Steven0811/moonwalk/cad/out/model_report.md

# Phase 2 — Model report

Generated by `cad/build.py` on 2026-10-03 21:30. Do not edit by hand.

Default foot variant (robot.yaml `foot_variant`): **wheel**. Hip roll: **off**.

## Check results (`cad/checks.py`)

**wheel foot**

| Check | Result | Details |
|---|---|---|
| Servo STEP: validation, measured dims = robot.yaml, simplified vs STEP bbox | PASS | case (20.0, 34.0, 22.97) mm (spec 34x20x23 ±0.3 on the case body; full model incl. horns+screws (20.0, 34.0, 30.2)); max |measured − robot.yaml| = 0.030 mm; holes match: True; cable exits match: True; simplified-vs-STEP bbox Δ = (0.0, 0.0, 0.0) mm |
| Joint positive directions (root CLAUDE.md conventions) | PASS | L: hip+ forward True, knee+ heel back True, ankle− toe down True; R: hip+ forward True, knee+ heel back True, ankle− toe down True |
| Zero pose: soles parallel, both at z = 0 (±0.5 mm) | PASS | L: sole parallel to ground True, lowest point z = +0.000 mm; R: sole parallel to ground True, lowest point z = +0.000 mm |
| Foot switch-over angle (wheel) | PASS | flat: support lowest +0.00 mm, pad 7.84 mm above it, foot body 1.50 mm above it; pad touches at 10.00° plantarflexion (design 10.0°, criterion 8–12°); foot body clearance at that angle 0.44 mm |
| Left/right symmetry (mass, CoM, joint origins mirrored) | PASS | thigh: Δm 0.000 g, Δcom(mirrored) 0.000 mm; shank: Δm 0.000 g, Δcom(mirrored) 0.000 mm; foot: Δm 0.000 g, Δcom(mirrored) 0.000 mm; wheel: Δm 0.000 g, Δcom(mirrored) 0.000 mm; base_link com x -0.75 mm (electronics placement, not mirrored) |
| Every printed part fits the build volume | PASS | bed 220×220×250 mm; all fit |
| Electronics placeholders in the tray, no mutual interference, battery inside the phase-1 region | PASS | battery over rail travel [-15, +15] mm: max overlap 0.00 mm³; phase-1 allowed battery Δy ∈ [-35, +35] mm → rail inside: True |
| Mass budget and CoM height vs phase 1 | PASS | total 382.3 g (limit 700 g); phase 1: 376.3 g → Δ +1.6 %; CoM height at the standing pose 118.8 mm vs phase 1 119.4 mm → Δ -0.5 % (criterion ±10 %) |
| Hard stops engage at the robot.yaml limits (±1°) | PASS | L_hip_pitch -30°: engages at -30.00° ✔; L_hip_pitch +90°: engages at +90.00° ✔; L_knee_pitch +0°: engages at -0.00° ✔; L_knee_pitch +120°: engages at +120.00° ✔; L_ankle_pitch -35°: engages at -35.00° ✔; L_ankle_pitch +30°: engages at +30.00° ✔ |
| Interference sweep | PASS | 107 poses (every joint over its full range at ≤ 5° steps, all 27 limit combinations per leg, both legs at limits), 41 s; no intersection > 0.05 mm³ between any two links or inside a link; 14 designed press fits (bearings/clutch in their seats, each ≤ 1.25 x its designed volume, largest 3.05 mm³) |
| Hip-roll variant (switch on) builds and passes | PENDING | NOT BUILT YET: hip_roll.enabled is false (default). The L_hip module is not modelled in this iteration; the pelvis plate keeps |x| 16–40 mm free and the hip modules are separate parts so it can be added later. |

**ptfe foot**

| Check | Result | Details |
|---|---|---|
| Servo STEP: validation, measured dims = robot.yaml, simplified vs STEP bbox | PASS | case (20.0, 34.0, 22.97) mm (spec 34x20x23 ±0.3 on the case body; full model incl. horns+screws (20.0, 34.0, 30.2)); max |measured − robot.yaml| = 0.030 mm; holes match: True; cable exits match: True; simplified-vs-STEP bbox Δ = (0.0, 0.0, 0.0) mm |
| Joint positive directions (root CLAUDE.md conventions) | PASS | L: hip+ forward True, knee+ heel back True, ankle− toe down True; R: hip+ forward True, knee+ heel back True, ankle− toe down True |
| Zero pose: soles parallel, both at z = 0 (±0.5 mm) | PASS | L: sole parallel to ground True, lowest point z = -0.500 mm; R: sole parallel to ground True, lowest point z = -0.500 mm |
| Foot switch-over angle (ptfe) | PASS | flat: sole lowest; pad 1.06 mm above; pad touches at 9.99° (criterion 8–12°) |
| Left/right symmetry (mass, CoM, joint origins mirrored) | PASS | thigh: Δm 0.000 g, Δcom(mirrored) 0.000 mm; shank: Δm 0.000 g, Δcom(mirrored) 0.000 mm; foot: Δm 0.000 g, Δcom(mirrored) 0.000 mm; base_link com x -0.75 mm (electronics placement, not mirrored) |
| Every printed part fits the build volume | PASS | bed 220×220×250 mm; all fit |
| Electronics placeholders in the tray, no mutual interference, battery inside the phase-1 region | PASS | battery over rail travel [-15, +15] mm: max overlap 0.00 mm³; phase-1 allowed battery Δy ∈ [-85, +90] mm → rail inside: True |
| Mass budget and CoM height vs phase 1 | PASS | total 374.4 g (limit 700 g); phase 1: 368.3 g → Δ +1.7 %; CoM height at the standing pose 124.2 mm vs phase 1 124.9 mm → Δ -0.6 % (criterion ±10 %) |
| Hard stops engage at the robot.yaml limits (±1°) | PASS | L_hip_pitch -30°: engages at -30.00° ✔; L_hip_pitch +90°: engages at +90.00° ✔; L_knee_pitch +0°: engages at -0.00° ✔; L_knee_pitch +120°: engages at +120.00° ✔; L_ankle_pitch -35°: engages at -35.00° ✔; L_ankle_pitch +30°: engages at +30.00° ✔ |
| Interference sweep | PASS | 107 poses (every joint over its full range at ≤ 5° steps, all 27 limit combinations per leg, both legs at limits), 33 s; no intersection > 0.05 mm³ between any two links or inside a link; 8 designed press fits (bearings/clutch in their seats, each ≤ 1.25 x its designed volume, largest 1.17 mm³) |
| Hip-roll variant (switch on) builds and passes | PENDING | NOT BUILT YET: hip_roll.enabled is false (default). The L_hip module is not modelled in this iteration; the pelvis plate keeps |x| 16–40 mm free and the hip modules are separate parts so it can be added later. |

## Mass, centre of mass, inertia per link

Link frame = origin on the joint axis to the parent, zero-pose orientation (Z up, +Y forward). Inertia about the CoM. The box check compares the trace of the inertia with that of a solid box of the link's bounding-box size and the same mass (an order-of-magnitude difference would mean a unit error).

### wheel foot — total **382.3 g**

| Link | Mass [g] | CoM [mm] | Ixx, Iyy, Izz [g·mm²] | Ixy, Ixz, Iyz | trace / box trace |
|---|---|---|---|---|---|
| base_link | 148.87 | -0.8, -0.2, +27.7 | 68530, 123950, 94993 | 21, 1044, 138 | 0.67 |
| L_thigh | 44.11 | -0.0, +0.4, -57.3 | 28050, 30133, 5688 | -1, -21, 377 | 0.63 |
| L_shank | 44.16 | -0.4, +0.5, -43.0 | 16910, 18627, 5030 | 372, -209, 180 | 0.48 |
| L_foot | 25.29 | -1.1, +2.0, -14.6 | 9517, 4750, 11230 | -0, 252, -559 | 0.79 |
| L_wheel | 3.16 | -0.0, +0.0, -0.0 | 17, 702, 702 | 0, -0, -0 | 1.21 |
| R_thigh | 44.11 | +0.0, +0.4, -57.3 | 28050, 30133, 5688 | 1, 21, 377 | 0.63 |
| R_shank | 44.16 | +0.4, +0.5, -43.0 | 16910, 18627, 5030 | -372, 209, 180 | 0.48 |
| R_foot | 25.29 | +1.1, +2.0, -14.6 | 9517, 4750, 11230 | 0, -252, -559 | 0.79 |
| R_wheel | 3.16 | -0.0, +0.0, +0.0 | 17, 702, 702 | -0, 0, -0 | 1.21 |

Whole-robot CoM at the zero pose: (-0.3, +0.1, 124.2) mm.

### ptfe foot — total **374.4 g**

| Link | Mass [g] | CoM [mm] | Ixx, Iyy, Izz [g·mm²] | Ixy, Ixz, Iyz | trace / box trace |
|---|---|---|---|---|---|
| base_link | 148.87 | -0.8, -0.2, +27.7 | 68530, 123950, 94993 | 21, 1044, 138 | 0.67 |
| L_thigh | 44.11 | -0.0, +0.4, -57.3 | 28050, 30133, 5688 | -1, -21, 377 | 0.63 |
| L_shank | 44.16 | -0.4, +0.5, -43.0 | 16910, 18627, 5030 | 372, -209, 180 | 0.48 |
| L_foot | 24.50 | -1.3, +5.4, -17.6 | 8339, 5152, 8992 | -114, 323, 410 | 0.71 |
| R_thigh | 44.11 | +0.0, +0.4, -57.3 | 28050, 30133, 5688 | 1, 21, 377 | 0.63 |
| R_shank | 44.16 | +0.4, +0.5, -43.0 | 16910, 18627, 5030 | -372, 209, 180 | 0.48 |
| R_foot | 24.50 | +1.3, +5.4, -17.6 | 8339, 5152, 8992 | 114, -323, 410 | 0.71 |

Whole-robot CoM at the zero pose: (-0.3, +0.8, 126.3) mm.

### Bodies per link (left leg; the right is the mirror image)

| Link | Body | Material | Mass [g] | Note |
|---|---|---|---|---|
| base_link | hip_module_L | petg_structural | 8.00 | print on its side (X vertical): sagittal loads stay in-layer |
| base_link | hip_module_R | petg_structural | 8.00 | print on its side (X vertical): sagittal loads stay in-layer |
| base_link | hip_servo_L | purchased | 21.00 |  |
| base_link | hip_servo_R | purchased | 21.00 |  |
| base_link | pelvis_plate | petg_structural | 8.46 | print flat (Z up): the hip loads bend it about Y, stresses along X stay in-layer |
| base_link | tray | petg_light | 7.81 |  |
| base_link | elec_battery | purchased | 30.00 | placeholder |
| base_link | elec_controller | purchased | 12.00 | placeholder |
| base_link | elec_bus_adapter | purchased | 6.00 | placeholder |
| base_link | elec_imu | purchased | 2.00 | placeholder |
| base_link | elec_power_switch | purchased | 1.00 | placeholder |
| base_link | screws_hip_module_L | purchased | 3.00 |  |
| base_link | screws_hip_module_R | purchased | 3.00 |  |
| base_link | screws_tray | purchased | 2.60 |  |
| base_link | wiring_base | purchased | 15.00 | bus wiring, battery leads, switch leads |
| L_thigh | thigh | petg_structural | 17.11 | print on its side (X vertical) |
| L_thigh | knee_servo | purchased | 21.00 |  |
| L_thigh | screws_hip_horns | purchased | 2.00 |  |
| L_thigh | screws_knee_servo_case | purchased | 1.00 |  |
| L_thigh | wiring_thigh | purchased | 3.00 |  |
| L_shank | shank | petg_structural | 12.30 | print on its side (X vertical) |
| L_shank | ankle_cover | petg_structural | 0.95 | inner side wall of the ankle-servo pocket; 4 x M2 + 2 case screws |
| L_shank | ankle_servo | purchased | 21.00 |  |
| L_shank | ankle_bearing_out | purchased | 0.30 | MR63ZZ |
| L_shank | ankle_bearing_in | purchased | 0.30 | MR63ZZ |
| L_shank | screws_knee_horns | purchased | 2.00 |  |
| L_shank | screws_ankle_servo_case | purchased | 1.50 |  |
| L_shank | crank_insert | purchased | 0.15 |  |
| L_shank | ankle_cover_screws_inserts | purchased | 1.60 |  |
| L_shank | wiring_shank | purchased | 2.00 |  |
| L_shank | crank | petg_structural | 0.61 |  |
| L_shank | rod | petg_structural | 0.46 |  |
| L_shank | rod_bearing_crank | purchased | 0.20 | MR52ZZ |
| L_shank | pin_crank | purchased | 0.30 | M2x8 shoulder screw |
| L_shank | rod_bearing_lever | purchased | 0.20 | MR52ZZ |
| L_shank | pin_lever | purchased | 0.30 | M2x8 shoulder screw |
| L_foot | foot | petg_structural | 19.75 | wheel variant; print on its side (X vertical) |
| L_foot | toe_pad | tpu_85a | 1.89 | print face down |
| L_foot | ankle_pin | purchased | 2.30 | M3x30 screw + M3 nylock nut |
| L_foot | lever_insert | purchased | 0.15 |  |
| L_foot | wheel_clutch | purchased | 0.60 | HF0306 one-way needle clutch |
| L_foot | wheel_bearing_out | purchased | 0.30 | MR63ZZ |
| L_foot | wheel_bearing_in | purchased | 0.30 | MR63ZZ |
| L_wheel | wheel_out | tpu_85a | 0.38 |  |
| L_wheel | wheel_in | tpu_85a | 0.38 |  |
| L_wheel | axle | purchased | 2.40 | 3 mm hardened steel pin |
| L_foot (ptfe) | foot | petg_structural | 19.16 | ptfe variant; print on its side (X vertical) |
| L_foot (ptfe) | toe_pad | tpu_85a | 1.89 | print face down |
| L_foot (ptfe) | ankle_pin | purchased | 2.30 | M3x30 screw + M3 nylock nut |
| L_foot (ptfe) | lever_insert | purchased | 0.15 |  |
| L_foot (ptfe) | ptfe_tape | purchased | 1.00 | PTFE tape on the sole |

### Mass budget (cad/CLAUDE.md) vs model

| Item | Budget | Model |
|---|---|---|
| servos | 126 g | 126.0 g |
| electronics | ~55 g (battery 30 + boards 25) | 51.0 g |
| printed | ~300 g | 138.4 g |
| hardware/wiring | ~80 g | 60.6 g |
| wheel set | 6–12 g | 6.3 g |
| **total** | ~570 g, limit 700 g | **382.3 g** |

Printed masses use the effective densities in robot.yaml (estimates until the slicer / scale gives real numbers). The printed structure is far lighter than the 300 g budget line: the parts are thin (2–3.5 mm walls) and the effective density assumes 4 walls + 30 % gyroid.

## Servo model (vendor STEP)

Source `cad/vendor/feetech_hd1910/HD-1910-C001.stp` (see SOURCE.md). Servo frame S: origin on the output-shaft axis at the output-horn face, +Z out of the output horn, +Y toward the case's long end. Measured in code:

| Quantity (S frame, mm) | Measured |
|---|---|
| case | [20.0, 34.0, 22.97] |
| case_center | [0.0, 7.5, -14.49] |
| horn_diameter | 15.99 |
| horn_thickness | 4.0 |
| horn_face_to_case | 3.0 |
| idle_horn_face_z | -29.0 |
| horn_hole_pcd | 12.0 |
| mount_hole_depth | 3.5 |
| horn_hole_count | 8 |
| mount_holes | [[-8.0, -7.5], [-8.0, 22.5], [8.0, -7.5], [8.0, 22.5]] |
| cable_exit | [[-10.000000000000114, 8.75, -18.45], [10.000000000000114, 8.75, -18.45]] |

Simplified shape (case box + horn discs + horn-screw heads) vs full STEP bounding box: Δ = (0.0, 0.0, 0.0) mm (criterion < 0.5 mm). Validation note: the spec's 34 × 20 × 23 mm bounding-box check applies to the case body (measured 34.00 × 20.00 × 22.97 mm). The full STEP also contains both horns and their screws, 20 × 34 × 30.2 mm; horn face to horn face is 29.0 mm, as on the datasheet. Units are mm.

## Joints (URDF)

| Joint | Parent → child | Origin [mm] | Axis | Range [°] | Effort / velocity |
|---|---|---|---|---|---|
| L_hip_pitch | base_link → L_thigh | -28.0, +0.0, +0.0 | (1, 0, 0) | -30 … +90 | 0.88 N·m / 7.64 rad/s |
| L_knee_pitch | L_thigh → L_shank | +0.0, +0.0, -80.0 | (-1, 0, 0) | +0 … +120 | 0.88 N·m / 7.64 rad/s |
| L_ankle_pitch | L_shank → L_foot | +0.0, +0.0, -72.0 | (1, 0, 0) | -35 … +30 | 0.88 N·m / 7.64 rad/s |
| L_wheel_axle | L_foot → L_wheel | +0.0, -18.0, -22.0 | (1, 0, 0) | continuous (passive) | — |
| R_hip_pitch | base_link → R_thigh | +28.0, +0.0, +0.0 | (1, 0, 0) | -30 … +90 | 0.88 N·m / 7.64 rad/s |
| R_knee_pitch | R_thigh → R_shank | +0.0, +0.0, -80.0 | (-1, 0, 0) | +0 … +120 | 0.88 N·m / 7.64 rad/s |
| R_ankle_pitch | R_shank → R_foot | +0.0, +0.0, -72.0 | (1, 0, 0) | -35 … +30 | 0.88 N·m / 7.64 rad/s |
| R_wheel_axle | R_foot → R_wheel | +0.0, -18.0, -22.0 | (1, 0, 0) | continuous (passive) | — |

Servo rotation sense (for firmware): every servo's output horn faces outward. For the left leg the servo +Z_S is −X, so a positive servo rotation (CCW seen from the horn) is a rotation about −X: hip and ankle angles = −servo angle, knee angle = +servo angle. For the right leg (+Z_S = +X) the signs flip. Measure this on the bench before trusting it.

Ankle drive: parallelogram linkage (crank 12 mm on the ankle servo, rod, equal lever on the foot), so ankle angle = servo angle. The URDF models the ankle as a direct revolute joint; crank and rod mass is lumped into the shank. **Estimated linkage backlash 0.2° (two MR52ZZ pin joints) on top of the servo's 0.5° → train/ servo model: ankle backlash ≈ 0.7°.**

## Collision primitives (names for train/ physics-material binding)

| Link | Name | Type | Zone | Centre [mm] | Size [mm] | rpy [°] |
|---|---|---|---|---|---|---|
| base_link (wheel) | `base_link_body` | box | body | +0.0, +0.0, +11.4 | 88.0, 20.0, 30.9 | 0, 0, 0 |
| base_link (wheel) | `base_link_tray` | box | body | +0.0, +0.0, +36.0 | 86.0, 42.0, 18.1 | 0, 0, 0 |
| base_link (wheel) | `base_link_battery` | box | body | +0.0, +0.0, +53.0 | 32.0, 58.0, 16.0 | 0, 0, 0 |
| L_thigh (wheel) | `L_thigh_body` | box | body | +0.0, +0.0, -52.5 | 32.0, 22.8, 72.0 | 0, 0, 0 |
| L_shank (wheel) | `L_shank_body` | box | body | +0.0, +0.0, -43.6 | 24.6, 22.0, 37.3 | 0, 0, 0 |
| L_foot (wheel) | `L_foot_toe_pad` | box | toe_pad | +0.0, +34.0, -16.3 | 44.0, 15.8, 3.0 | 18, 0, 0 |
| L_foot (wheel) | `L_foot_heel` | box | heel | +0.0, -18.0, -25.0 | 35.2, 16.0, 3.0 | 0, 0, 0 |
| L_foot (wheel) | `L_foot_body` | box | body | +0.0, +1.0, -8.5 | 42.0, 50.0, 9.0 | 0, 0, 0 |
| L_wheel (wheel) | `L_wheel_out` | sphere | wheel | -20.0, +0.0, +0.0 | 6.0 | 0, 0, 0 |
| L_wheel (wheel) | `L_wheel_in` | sphere | wheel | +20.0, +0.0, +0.0 | 6.0 | 0, 0, 0 |
| L_foot (ptfe) | `L_foot_toe_pad` | box | toe_pad | +0.0, +34.0, -23.1 | 44.0, 15.8, 3.0 | 18, 0, 0 |
| L_foot (ptfe) | `L_foot_heel` | box | heel | +0.0, -20.0, -26.5 | 44.0, 12.0, 3.0 | 0, 0, 0 |
| L_foot (ptfe) | `L_foot_sole` | box | sole | +0.0, +3.5, -26.5 | 44.0, 35.0, 3.0 | 0, 0, 0 |
| L_foot (ptfe) | `L_foot_body` | box | body | +0.0, +1.0, -8.5 | 42.0, 50.0, 9.0 | 0, 0, 0 |

Naming scheme (robot.yaml `collision.names`): `{side}_foot_toe_pad`, `{side}_foot_sole`, `{side}_foot_heel`, `{side}_wheel_in` / `_out` (spheres), `{side}_{link}_body`, `base_link_*`.

## Printed parts (`cad/out/stl/`, already in print orientation)

| File | Material | Mass est. [g] | Size in print orientation [mm] | Note |
|---|---|---|---|---|
| ankle_cover_L.stl | petg_structural | 0.9 | 38 × 32 × 2 | inner side wall of the ankle-servo pocket; 4 x M2 + 2 case screws |
| ankle_cover_R.stl | petg_structural | 0.9 | 38 × 32 × 2 | inner side wall of the ankle-servo pocket; 4 x M2 + 2 case screws |
| crank_L.stl | petg_structural | 0.6 | 18 × 26 × 4 |  |
| crank_R.stl | petg_structural | 0.6 | 18 × 26 × 4 |  |
| foot_ptfe_L.stl | petg_structural | 19.2 | 35 × 67 × 44 | ptfe variant; print on its side (X vertical) |
| foot_ptfe_R.stl | petg_structural | 19.2 | 35 × 67 × 44 | ptfe variant; print on its side (X vertical) |
| foot_wheel_L.stl | petg_structural | 19.7 | 34 × 67 × 44 | wheel variant; print on its side (X vertical) |
| foot_wheel_R.stl | petg_structural | 19.7 | 34 × 67 × 44 | wheel variant; print on its side (X vertical) |
| hip_module_L.stl | petg_structural | 8.0 | 32 × 34 × 34 | print on its side (X vertical): sagittal loads stay in-layer |
| hip_module_R.stl | petg_structural | 8.0 | 32 × 34 × 34 | print on its side (X vertical): sagittal loads stay in-layer |
| pelvis_plate.stl | petg_structural | 8.5 | 90 × 44 × 3 | print flat (Z up): the hip loads bend it about Y, stresses along X stay in-layer |
| rod_L.stl | petg_structural | 0.5 | 43 × 8 × 3 |  |
| rod_R.stl | petg_structural | 0.5 | 43 × 8 × 3 |  |
| shank_L.stl | petg_structural | 12.3 | 95 × 32 × 34 | print on its side (X vertical) |
| shank_R.stl | petg_structural | 12.3 | 95 × 32 × 34 | print on its side (X vertical) |
| thigh_L.stl | petg_structural | 17.1 | 109 × 27 × 34 | print on its side (X vertical) |
| thigh_R.stl | petg_structural | 17.1 | 109 × 27 × 34 | print on its side (X vertical) |
| toe_pad_L.stl | tpu_85a | 1.9 | 44 × 16 × 5 | print face down |
| toe_pad_R.stl | tpu_85a | 1.9 | 44 × 16 × 5 | print face down |
| tolerance_holes.stl | petg_structural | 19.9 | 50 × 90 × 6 |  |
| tolerance_horn.stl | petg_structural | 4.7 | 70 × 24 × 4 |  |
| tolerance_servo_collars.stl | petg_structural | 2.8 | 79 × 39 × 5 |  |
| tray.stl | petg_light | 7.8 | 88 × 60 × 15 |  |
| wheel.stl | tpu_85a | 0.4 | 12 × 12 × 4 |  |

First print **tolerance_holes / tolerance_horn / tolerance_servo_collars** and report which sizes fit; the values go to robot.yaml `print:`.

## Views

iso wheel
iso_back wheel
front wheel
side wheel
top wheel

gait wheel

iso ptfe
iso_back ptfe
front ptfe
side ptfe
top ptfe

gait ptfe

Build time 280 s.
