Steven0811/moonwalk/cad/out/sizing_report.md

# Phase 1 — Sizing feasibility report

Generated by `cad/analysis/sizing_report.py` on 2026-10-01 22:41. Do not edit by hand.

Method: quasi-static analysis of the 4-s slow gait in `config/gait.yaml` (both halves, 60 samples per half). Each sample is an equilibrium pose: feet roll without slipping between the flat / switch / toe states, the pelvis height is constant, the pelvis fore-aft keyframes are optimised to maximise the worst static margin. Margins are measured along the Y line (fore-aft) and X line (lateral) through the CoM projection, as the spec states; the Euclidean distance to the nearest polygon edge is listed for information. Torques: static gravity + ground reaction, with the sliding foot carrying a forward friction force μ = 0.15 (worst case of the 0.05–0.15 target) reacted by the support foot. Because two feet on the ground make the load split statically indeterminate, two numbers are given: **best** = the split minimising the largest torque ratio (what a good controller can reach), **worst** = the largest |τ| over every admissible split (an upper bound, independent of the controller). The pass criterion uses the worst case.

## 1. Selected design (values now in config/)

| Parameter | Value |
|---|---|
| Leg length (hip axis → sole) | 180 mm |
| Thigh / shank | 80 / 72 mm |
| Ankle height | 28 mm |
| Stance width (hip spacing) | 56 mm |
| Foot toe / heel length, width | 42 / 26 mm, 44 mm |
| Toe pad length, wedge face angle | 15 mm, 18° |
| Switch-over angle (design) | 10° |
| Wheel Ø, axle y, track | 12 mm, -18 mm, 40 mm |
| PTFE sole front edge → pad gap | 6 mm |
| Step length (per cycle) | 40 mm |
| Cycle time | 4.0 s |

| Metric (both halves of the cycle) | wheel | ptfe | Criterion |
|---|---|---|---|
| Hip height H (derived: back-of-slide knee = 27°) | 174.3 mm (96.8 % of leg) | 175.3 mm (97.4 % of leg) | 90–95 % suggested |
| Knee of sliding leg at back of slide | 27.0° | 27.0° | 15–30° |
| Reachable, all joints in range, knee ≥ 5° throughout | yes | yes | yes |
| Min fore-aft margin | 14.1 mm | 20.4 mm | ≥ 10 mm |
| Min lateral margin | 14.1 mm | 27.9 mm | ≥ 10 mm |
| Min Euclidean margin (info) | 10.8 mm | 17.5 mm | — |
| Static τ p99 hip: worst / best | 0.064 / 0.050 N·m (30 %) | 0.098 / 0.027 N·m (45 %) | worst ≤ 0.216 |
| Static τ p99 knee: worst / best | 0.057 / 0.052 N·m (26 %) | 0.060 / 0.039 N·m (28 %) | worst ≤ 0.216 |
| Static τ p99 ankle: worst / best | 0.071 / 0.064 N·m (33 %) | 0.064 / 0.039 N·m (29 %) | worst ≤ 0.216 |
| Joint angle range used: hip | 2.0 … 16.4° | 7.7 … 26.4° | −30 … 90 |
| knee | 16.1 … 31.5° | 26.8 … 43.2° | 0 … 120 |
| ankle | -4.7 … 22.4° | -3.4 … 19.1° | −35 … 30 |
| Total mass (estimate) | 376 g | 368 g | ≤ 700 g |
| Mean CoM height | 120.8 mm | 125.1 mm | phase-2 check ±10 % |
| **Pass** | **yes** | **yes** |  |

Pelvis keyframes (wheel), y relative to the support foot's flat position: slide_start +22.6, slide_mid +19.4, slide_end +1.1, transfer -1.6, raise +3.3 mm.

Pelvis keyframes (ptfe), y relative to the support foot's flat position: slide_start +10.1, slide_mid +3.2, slide_end -7.7, both_flat -7.1 mm.

cycle wheel
cycle ptfe

keyframes wheel
polygons wheel

keyframes ptfe
polygons ptfe

## 2. Foot geometry and switch-over angle

The toe pad is a TPU **wedge**: its face rises toward the toe at the face angle, so in the toe-raised support state the whole pad face is flat on the ground (a patch, not a line). Its rear edge is recessed above the ground so that, as the foot plantarflexes about its first pivot (wheel axle, or PTFE sole front edge), the rear edge touches exactly at the switch-over angle. Recess = f(pivot, switch angle); it is derived, not typed.

| | wheel | ptfe |
|---|---|---|
| First pivot (y, z) in foot frame | (-18.0, -22.0) | (21.0, -28.0) |
| Pad rear-edge recess above ground (flat) | 7.84 mm | 1.06 mm |
| Pad tip height above ground (flat) | 12.72 mm | 5.93 mm |
| θ = 0° plantarflexion: touching | wheel, wheel bottom 0.0 mm | sole |
| θ = 5° plantarflexion: touching | wheel, wheel bottom 0.0 mm | sole |
| θ = 8° plantarflexion: touching | wheel, wheel bottom 0.0 mm | sole |
| θ = 10° plantarflexion: touching | pad+wheel, wheel bottom 0.0 mm | pad+sole |
| θ = 12° plantarflexion: touching | pad, wheel bottom 1.6 mm | pad |
| θ = 15° plantarflexion: touching | pad, wheel bottom 3.9 mm | pad |
| θ = 18° plantarflexion: touching | pad, wheel bottom 6.2 mm | pad |
| θ = 22° plantarflexion: touching | pad, wheel bottom 10.2 mm | pad |

Switch-over at 10° (criterion 8–12°): flat → only wheels / sole touch; at 10° the pad rear edge joins; past it the wheels lift; at 18° the whole pad face is down.

Wheel parts (starting choice, fits the 10 mm wheel): 3 mm steel axle, one-way needle clutch HF0306 (3 × 6.5 × 6 mm) pressed into the foot body on the axle, MR63ZZ (3 × 6 × 2.5) on the other side; the two printed rims are fixed to the axle so both lock together. Estimated set mass ≈ 4 g per foot (< 6 g). Interference of the wheels with the ankle linkage is checked in phase 2 (`cad/checks.py`); in phase 1 the ankle lever (r = 12 mm about the ankle axis) sweeps z ≥ −7 mm in the foot frame, the wheel top is at z = -16 mm: clear by ≥ 9 mm.

## 3. Sweeps

Every row re-derives the hip height (knee 27° at the back of the slide unless the row varies it) and re-optimises the pelvis keyframes. `fa`/`lat` = minimum fore-aft / lateral margin [mm]; τ = worst-case static p99 [N·m] hip/knee/ankle. ✔ = all criteria met.

### Leg length (thigh, shank, ankle height scaled together) (wheel)

| scale (1.0 = 180 mm) | H [mm] | knee@back | fa | lat | τ hip / knee / ankle | feasible | ✔ |
|---|---|---|---|---|---|---|---|
| 0.85 | 147 | 28.5 | 14.9 | 14.9 | 0.063 / 0.060 / 0.067 | yes | ✔ |
| 0.9 | 157 | 27.3 | 14.7 | 14.7 | 0.064 / 0.062 / 0.073 | yes | ✔ |
| 1.0 | 174 | 27.0 | 14.1 | 14.1 | 0.064 / 0.057 / 0.071 | yes | ✔ |
| 1.1 | 192 | 26.9 | 14.0 | 14.0 | 0.064 / 0.064 / 0.069 | yes | ✔ |
| 1.2 | 210 | 27.1 | 14.0 | 14.0 | 0.064 / 0.060 / 0.068 | yes | ✔ |

### Thigh share of thigh + shank (wheel)

| thigh fraction | H [mm] | knee@back | fa | lat | τ hip / knee / ankle | feasible | ✔ |
|---|---|---|---|---|---|---|---|
| 0.48 | 174 | 27.0 | 14.0 | 14.0 | 0.064 / 0.060 / 0.071 | yes | ✔ |
| 0.5 | 174 | 26.8 | 14.0 | 14.0 | 0.064 / 0.064 / 0.071 | yes | ✔ |
| 0.526 | 174 | 27.0 | 14.1 | 14.1 | 0.064 / 0.057 / 0.076 | yes | ✔ |
| 0.55 | 174 | 27.4 | 14.5 | 14.5 | 0.064 / 0.063 / 0.075 | yes | ✔ |
| 0.58 | 174 | 26.9 | 14.3 | 14.3 | 0.063 / 0.057 / 0.075 | yes | ✔ |

### Ankle height (wheel)

| ankle height [mm] | H [mm] | knee@back | fa | lat | τ hip / knee / ankle | feasible | ✔ |
|---|---|---|---|---|---|---|---|
| 22.0 | 168 | 27.1 | 14.4 | 14.4 | 0.064 / 0.065 / 0.080 | yes | ✔ |
| 25.0 | 171 | 27.0 | 14.1 | 14.1 | 0.064 / 0.057 / 0.079 | yes | ✔ |
| 28.0 | 174 | 27.0 | 14.1 | 14.1 | 0.064 / 0.057 / 0.071 | yes | ✔ |
| 32.0 | 178 | 27.0 | 14.0 | 14.0 | 0.063 / 0.060 / 0.069 | yes | ✔ |
| 36.0 | 182 | 27.1 | 14.0 | 14.0 | 0.063 / 0.064 / 0.066 | yes | ✔ |

### Nominal hip height (via the back-of-slide knee angle) (wheel)

| knee@back target [°] | H [mm] | knee@back | fa | lat | τ hip / knee / ankle | feasible | ✔ |
|---|---|---|---|---|---|---|---|
| 15.0 | 177 | 14.8 | 14.0 | 14.3 | — | unreachable @ slide_end | ✘ |
| 20.0 | 176 | 19.9 | 12.9 | 14.2 | — | unreachable @ slide_end | ✘ |
| 27.0 | 174 | 27.0 | 14.1 | 14.1 | 0.064 / 0.057 / 0.071 | yes | ✔ |
| 30.0 | 173 | 31.0 | 15.3 | 15.3 | 0.064 / 0.063 / 0.070 | yes | ✘ |
| 40.0 | 170 | 40.1 | 15.4 | 15.4 | 0.064 / 0.067 / 0.067 | yes | ✘ |

### Step length (wheel)

| step [mm] | H [mm] | knee@back | fa | lat | τ hip / knee / ankle | feasible | ✔ |
|---|---|---|---|---|---|---|---|
| 20.0 | 175 | 26.6 | 15.5 | 15.5 | 0.058 / 0.058 / 0.076 | yes | ✔ |
| 30.0 | 175 | 27.4 | 15.5 | 15.5 | 0.061 / 0.065 / 0.073 | yes | ✔ |
| 40.0 | 174 | 27.0 | 14.1 | 14.1 | 0.064 / 0.057 / 0.071 | yes | ✔ |
| 50.0 | 174 | 27.9 | 14.2 | 14.9 | 0.066 / 0.061 / 0.074 | yes | ✔ |
| 60.0 | 173 | 27.7 | 12.3 | 13.3 | 0.069 / 0.061 / 0.078 | yes | ✔ |

### Foot width (wheel)

| width [mm] | H [mm] | knee@back | fa | lat | τ hip / knee / ankle | feasible | ✔ |
|---|---|---|---|---|---|---|---|
| 32.0 | 175 | 27.3 | 9.7 | 9.7 | 0.064 / 0.059 / 0.067 | yes | ✘ |
| 36.0 | 174 | 27.0 | 10.7 | 10.7 | 0.064 / 0.067 / 0.071 | yes | ✔ |
| 40.0 | 174 | 27.0 | 12.7 | 12.7 | 0.064 / 0.057 / 0.074 | yes | ✔ |
| 44.0 | 174 | 27.0 | 14.1 | 14.1 | 0.064 / 0.057 / 0.071 | yes | ✔ |
| 48.0 | 174 | 27.2 | 16.1 | 16.1 | 0.064 / 0.059 / 0.076 | yes | ✔ |

### Stance width (wheel)

| hip spacing [mm] | H [mm] | knee@back | fa | lat | τ hip / knee / ankle | feasible | ✔ |
|---|---|---|---|---|---|---|---|
| 48.0 | 174 | 27.0 | 15.5 | 15.5 | 0.064 / 0.054 / 0.075 | yes | ✔ |
| 52.0 | 174 | 27.0 | 15.1 | 15.0 | 0.064 / 0.056 / 0.075 | yes | ✔ |
| 56.0 | 174 | 27.0 | 14.1 | 14.1 | 0.064 / 0.057 / 0.071 | yes | ✔ |
| 62.0 | 174 | 27.5 | 14.1 | 14.1 | 0.064 / 0.061 / 0.074 | yes | ✔ |
| 68.0 | 174 | 27.0 | 13.0 | 13.3 | 0.064 / 0.061 / 0.066 | yes | ✔ |

### Toe length (wheel)

| toe [mm] | H [mm] | knee@back | fa | lat | τ hip / knee / ankle | feasible | ✔ |
|---|---|---|---|---|---|---|---|
| 36.0 | 175 | 29.0 | 13.8 | 14.0 | 0.057 / 0.057 / 0.061 | yes | ✔ |
| 39.0 | 175 | 26.9 | 13.7 | 13.7 | 0.061 / 0.062 / 0.064 | yes | ✔ |
| 42.0 | 174 | 27.0 | 14.1 | 14.1 | 0.064 / 0.057 / 0.071 | yes | ✔ |
| 46.0 | 174 | 27.5 | 15.4 | 15.4 | 0.067 / 0.065 / 0.081 | yes | ✔ |
| 50.0 | 174 | 22.8 | 14.8 | 14.8 | 0.070 / 0.063 / 0.094 | yes | ✔ |

### Step length (ptfe)

| step [mm] | H [mm] | knee@back | fa | lat | τ hip / knee / ankle | feasible | ✔ |
|---|---|---|---|---|---|---|---|
| 20.0 | 176 | 27.0 | 19.0 | 26.6 | 0.096 / 0.060 / 0.055 | yes | ✔ |
| 30.0 | 176 | 25.8 | 19.5 | 27.9 | 0.096 / 0.059 / 0.060 | yes | ✔ |
| 40.0 | 175 | 27.0 | 20.4 | 27.9 | 0.098 / 0.060 / 0.064 | yes | ✔ |
| 50.0 | 175 | 27.0 | 20.6 | 28.4 | 0.098 / 0.060 / 0.069 | yes | ✔ |
| 60.0 | 175 | 27.2 | 20.3 | 28.0 | 0.099 / 0.062 / 0.075 | yes | ✔ |

### Foot width (ptfe)

| width [mm] | H [mm] | knee@back | fa | lat | τ hip / knee / ankle | feasible | ✔ |
|---|---|---|---|---|---|---|---|
| 32.0 | 175 | 26.9 | 17.8 | 22.2 | 0.076 / 0.059 / 0.060 | yes | ✔ |
| 36.0 | 175 | 27.0 | 18.4 | 24.4 | 0.082 / 0.059 / 0.061 | yes | ✔ |
| 40.0 | 175 | 27.6 | 19.7 | 25.9 | 0.090 / 0.060 / 0.062 | yes | ✔ |
| 44.0 | 175 | 27.0 | 20.4 | 27.9 | 0.098 / 0.060 / 0.064 | yes | ✔ |
| 48.0 | 175 | 27.1 | 21.2 | 29.8 | 0.106 / 0.060 / 0.067 | yes | ✔ |

### Stance width (ptfe)

| hip spacing [mm] | H [mm] | knee@back | fa | lat | τ hip / knee / ankle | feasible | ✔ |
|---|---|---|---|---|---|---|---|
| 48.0 | 175 | 27.0 | 22.1 | 26.7 | 0.113 / 0.061 / 0.070 | yes | ✔ |
| 52.0 | 175 | 27.4 | 21.3 | 27.2 | 0.105 / 0.061 / 0.065 | yes | ✔ |
| 56.0 | 175 | 27.0 | 20.4 | 27.9 | 0.098 / 0.060 / 0.064 | yes | ✔ |
| 62.0 | 175 | 27.7 | 19.6 | 28.4 | 0.090 / 0.061 / 0.062 | yes | ✔ |
| 68.0 | 175 | 27.1 | 18.5 | 29.9 | 0.083 / 0.059 / 0.061 | yes | ✔ |

### Toe length (ptfe)

| toe [mm] | H [mm] | knee@back | fa | lat | τ hip / knee / ankle | feasible | ✔ |
|---|---|---|---|---|---|---|---|
| 36.0 | 176 | 27.0 | 17.9 | 27.9 | 0.100 / 0.058 / 0.050 | yes | ✔ |
| 39.0 | 175 | 27.3 | 19.3 | 27.8 | 0.099 / 0.059 / 0.056 | yes | ✔ |
| 42.0 | 175 | 27.0 | 20.4 | 27.9 | 0.098 / 0.060 / 0.064 | yes | ✔ |
| 46.0 | 175 | 27.0 | 22.0 | 28.0 | 0.096 / 0.062 / 0.072 | yes | ✔ |
| 50.0 | 174 | 27.0 | 23.7 | 27.9 | 0.094 / 0.063 / 0.080 | yes | ✔ |

### Heel length (wheel)

| heel [mm] | H [mm] | knee@back | fa | lat | τ hip / knee / ankle | feasible | ✔ |
|---|---|---|---|---|---|---|---|
| 23.0 | 174 | 27.0 | 14.1 | 14.1 | 0.064 / 0.057 / 0.071 | yes | ✔ |
| 26.0 | 174 | 27.0 | 14.1 | 14.1 | 0.064 / 0.057 / 0.071 | yes | ✔ |
| 30.0 | 174 | 27.0 | 14.1 | 14.1 | 0.064 / 0.057 / 0.071 | yes | ✔ |

### Wheel axle position (wheel)

| axle y [mm] | H [mm] | knee@back | fa | lat | τ hip / knee / ankle | feasible | ✔ |
|---|---|---|---|---|---|---|---|
| -10.0 | 174 | 23.8 | 12.2 | 12.2 | 0.055 / 0.052 / 0.078 | yes | ✔ |
| -14.0 | 174 | 27.8 | 14.3 | 14.3 | 0.059 / 0.058 / 0.071 | yes | ✔ |
| -18.0 | 174 | 27.0 | 14.1 | 14.1 | 0.064 / 0.057 / 0.071 | yes | ✔ |
| -20.0 | 174 | 27.0 | 14.2 | 14.2 | 0.066 / 0.061 / 0.073 | yes | ✔ |

### Wheel diameter (wheel)

| Ø [mm] | H [mm] | knee@back | fa | lat | τ hip / knee / ankle | feasible | ✔ |
|---|---|---|---|---|---|---|---|
| 8.0 | 174 | 26.7 | 14.3 | 14.3 | 0.064 / 0.065 / 0.072 | yes | ✔ |
| 10.0 | 174 | 26.8 | 14.2 | 14.2 | 0.064 / 0.065 / 0.074 | yes | ✔ |
| 12.0 | 174 | 27.0 | 14.1 | 14.1 | 0.064 / 0.057 / 0.071 | yes | ✔ |

### Switch-over angle (wheel)

| switch [°] | H [mm] | knee@back | fa | lat | τ hip / knee / ankle | feasible | ✔ |
|---|---|---|---|---|---|---|---|
| 8.0 | 174 | 26.9 | 14.1 | 14.1 | 0.063 / 0.058 / 0.074 | yes | ✔ |
| 10.0 | 174 | 27.0 | 14.1 | 14.1 | 0.064 / 0.057 / 0.071 | yes | ✔ |
| 12.0 | 174 | 27.7 | 14.8 | 14.7 | 0.065 / 0.064 / 0.075 | yes | ✔ |

### PTFE pad gap (ptfe)

| gap [mm] | H [mm] | knee@back | fa | lat | τ hip / knee / ankle | feasible | ✔ |
|---|---|---|---|---|---|---|---|
| 3.0 | 175 | 27.0 | 22.0 | 28.8 | 0.098 / 0.058 / 0.070 | yes | ✔ |
| 6.0 | 175 | 27.0 | 20.4 | 27.9 | 0.098 / 0.060 / 0.064 | yes | ✔ |
| 10.0 | 176 | 26.8 | 18.6 | 26.1 | 0.098 / 0.064 / 0.056 | yes | ✔ |

### Factorial: step length × foot width × stance width × toe length (wheel, stability only)

81 combinations, 81 reach ≥ 10 mm in both directions. Best 12:

| step | foot width | stance | toe | fa | lat | euclid |
|---|---|---|---|---|---|---|
| 30 | 44 | 52 | 46 | 16.7 | 16.9 | 11.9 |
| 30 | 44 | 52 | 42 | 15.6 | 15.6 | 11.5 |
| 30 | 44 | 56 | 46 | 15.5 | 15.5 | 11.6 |
| 30 | 44 | 56 | 42 | 15.5 | 15.5 | 11.5 |
| 40 | 44 | 62 | 46 | 15.5 | 15.5 | 11.4 |
| 40 | 44 | 52 | 46 | 15.4 | 15.4 | 11.5 |
| 40 | 44 | 56 | 46 | 15.4 | 15.4 | 11.8 |
| 30 | 44 | 62 | 46 | 15.2 | 15.2 | 11.1 |
| 40 | 44 | 52 | 42 | 15.1 | 15.0 | 11.6 |
| 50 | 44 | 52 | 46 | 15.0 | 15.0 | 12.0 |
| 30 | 44 | 52 | 38 | 14.9 | 14.9 | 11.1 |
| 30 | 44 | 62 | 42 | 14.9 | 15.0 | 10.5 |

## 4. Electronics uncertainty and the battery placement region

The gait (pelvis keyframes and hip height) is held fixed at the selected design's values; the electronics mass is scaled by 0.5 / 1.0 / 1.5 and the battery centre is moved along Y in the pelvis frame. Battery height does not enter the static margin (the CoM projection ignores z) and is limited only by the pelvis geometry; it matters for dynamics, so it is randomised in phase 3.

**wheel** — worst margin [mm] vs battery Δy (columns) and electronics mass factor (rows):

| factor \ Δy | -120 | -100 | -80 | -60 | -40 | -20 | +0 | +20 | +40 | +60 | +80 | +100 | +120 |
|---|---|---|---|---|---|---|---|---|---|---|---|---|---|
| 0.5 | 9.1 | 10.0 | **10.8** | **11.7** | **12.5** | **13.4** | **14.1** | **13.2** | **12.4** | **11.5** | **10.7** | 9.8 | 9.0 |
| 1.0 | 4.5 | 6.1 | 7.7 | 9.3 | **10.9** | **12.5** | **14.1** | **12.5** | **10.9** | 9.3 | 7.7 | 6.1 | 4.5 |
| 1.5 | 0.5 | 2.8 | 5.0 | 7.2 | 9.5 | **11.7** | **14.0** | **11.8** | 9.6 | 7.4 | 5.1 | 2.9 | 0.6 |

Allowed battery centre (all three mass factors, margin ≥ 10 mm): **Δy ∈ [-35.0, +35.0] mm** about the nominal position y = +0.0 mm.
 Rail travel in robot.yaml: [-15, +15] mm → **rail inside the region**.

**ptfe** — worst margin [mm] vs battery Δy (columns) and electronics mass factor (rows):

| factor \ Δy | -120 | -100 | -80 | -60 | -40 | -20 | +0 | +20 | +40 | +60 | +80 | +100 | +120 |
|---|---|---|---|---|---|---|---|---|---|---|---|---|---|
| 0.5 | **15.6** | **16.4** | **17.3** | **18.2** | **19.1** | **19.9** | **19.9** | **19.1** | **18.2** | **17.3** | **16.4** | **15.6** | **14.7** |
| 1.0 | **10.6** | **12.2** | **13.8** | **15.5** | **17.1** | **18.7** | **20.4** | **18.7** | **17.1** | **15.5** | **13.8** | **12.2** | **10.6** |
| 1.5 | 6.1 | 8.4 | **10.7** | **12.9** | **15.2** | **17.5** | **19.8** | **18.4** | **16.2** | **13.9** | **11.6** | 9.3 | 7.0 |

Allowed battery centre (all three mass factors, margin ≥ 10 mm): **Δy ∈ [-85.0, +90.0] mm** about the nominal position y = +0.0 mm.
 Rail travel in robot.yaml: [-15, +15] mm → **rail inside the region**.

## 5. Standing pose (reset pose for train/)

Feet side by side at y = 0, knees pre-bent to 25° (spec: 15–30°), pelvis y chosen so the CoM is centred fore-aft in the support polygon. Joint angles are what train/ resets to.

- **wheel** (switch feet): H = 172.8 mm, pelvis y = -1.9 mm → hip 13.9°, knee 25.0°, ankle 1.1°; margins fore-aft 22.3, lateral 48.7 mm.
- **ptfe** (flat feet): H = 175.9 mm, pelvis y = -12.8 mm → hip 16.8°, knee 25.0°, ankle 8.2°; margins fore-aft 23.4, lateral 49.7 mm.

## 6. Pass criteria

**wheel**
- ✔ Static torque p99 ≤ 0.216 N·m (worst-case split): max 0.071 N·m
- ✔ Slow-gait static margin ≥ 10 mm: fore-aft 14.1, lateral 14.1 mm
- ✔ Sliding foot reaches the floor throughout (IK feasible, knee ≥ 5°, joints in range)
- ✔ Knee at back of slide 15–30°: 27.0°
- ✔ Switch-over angle 8–12°: 10° (by construction; verified geometrically in §2)
- ✔ Battery placement region non-empty: Δy ∈ [-35.0, +35.0] mm

**ptfe**
- ✔ Static torque p99 ≤ 0.216 N·m (worst-case split): max 0.098 N·m
- ✔ Slow-gait static margin ≥ 10 mm: fore-aft 20.4, lateral 27.9 mm
- ✔ Sliding foot reaches the floor throughout (IK feasible, knee ≥ 5°, joints in range)
- ✔ Knee at back of slide 15–30°: 27.0°
- ✔ Switch-over angle 8–12°: 10° (by construction; verified geometrically in §2)
- ✔ Battery placement region non-empty: Δy ∈ [-85.0, +90.0] mm

Runtime 254 s.
