Steven0811/moonwalk/cad/out/urdf/meshes/L_shank.stl

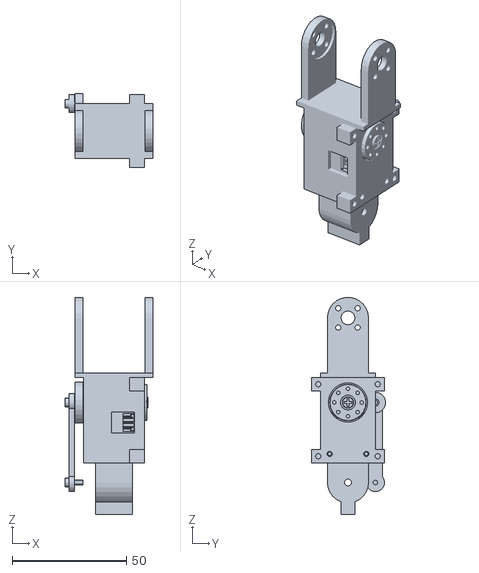
[picture p1: CAD file, 2026-10-03]
cad/out/urdf/meshes/L_shank.stl
38.4 x 32.5 x 94.9
