Steven0811/moonwalk/cad/out/urdf/meshes/R_thigh.stl

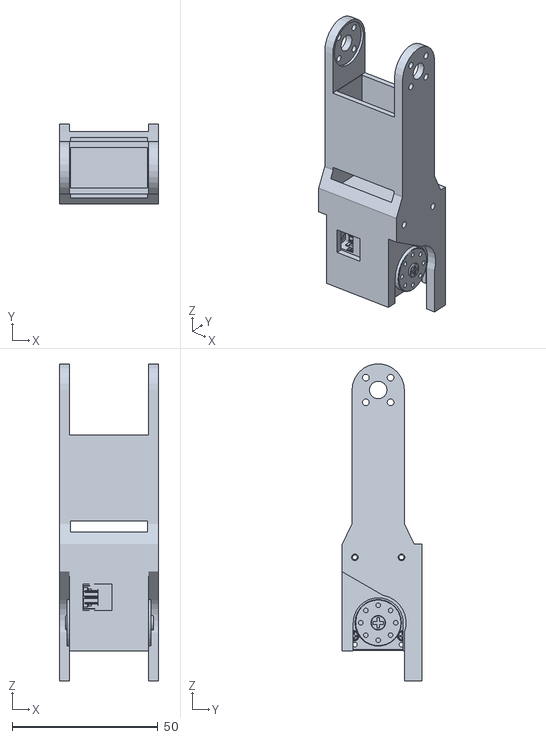
[picture p2: CAD file, 2026-10-03]
cad/out/urdf/meshes/R_thigh.stl
34.0 x 27.4 x 108.9
