Steven0811/moonwalk/cad/out/urdf/meshes/R_wheel.stl

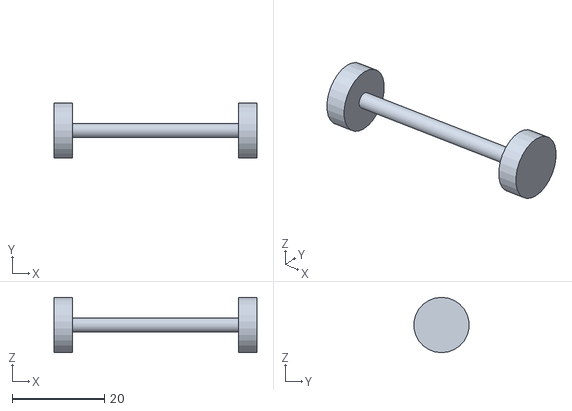
[picture p3: CAD file, 2026-10-03]
cad/out/urdf/meshes/R_wheel.stl
44.0 x 11.9 x 12.0
