Steven0811/moonwalk/cad/out/urdf/meshes/R_foot_wheel.stl

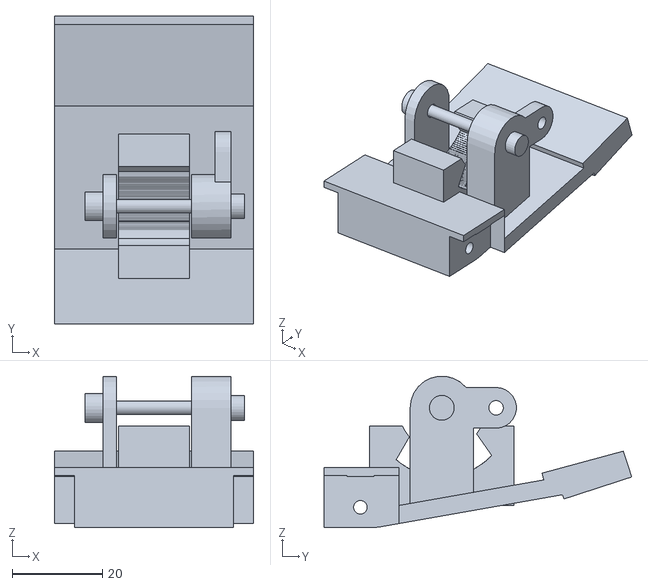
[picture p4: CAD file, 2026-10-03]
cad/out/urdf/meshes/R_foot_wheel.stl
44.0 x 68.0 x 33.5
