Steven0811/moonwalk/cad/out/urdf/meshes/R_foot_ptfe.stl

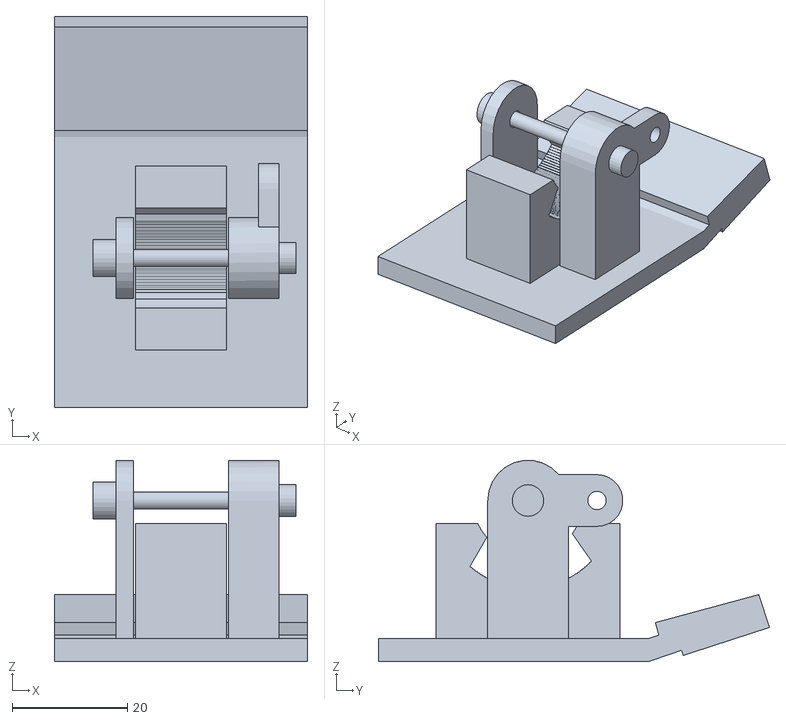
[picture p5: CAD file, 2026-10-03]
cad/out/urdf/meshes/R_foot_ptfe.stl
44.0 x 68.0 x 35.0
