Steven0811/moonwalk/cad/out/urdf/meshes/base_link.stl

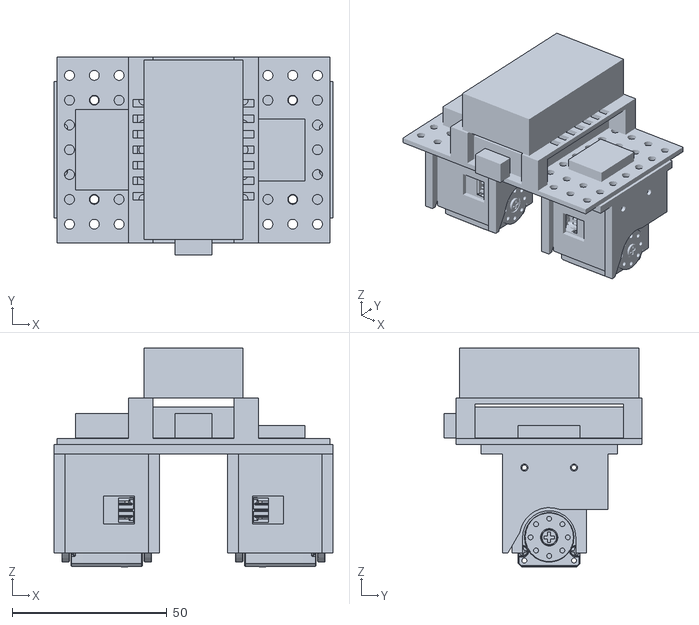
[picture p6: CAD file, 2026-10-03]
cad/out/urdf/meshes/base_link.stl
90.0 x 64.0 x 70.5
