Steven0811/moonwalk/(list of files, cad)

Other CAD files:
cad/out/urdf/meshes/L_thigh.stl
cad/out/urdf/meshes/L_wheel.stl
cad/out/urdf/meshes/R_shank.stl
cad/out/urdf/meshes/L_foot_wheel.stl
cad/out/urdf/meshes/L_foot_ptfe.stl
