Steven0811/moonwalk/cad/out/urdf/moonwalk_mini.urdf

<?xml version="1.0"?>
<!-- Generated by cad/build.py — do not edit. Foot variant: wheel. Total mass 382.3 g. Units: m, kg, kg·m², rad. -->
<robot name="moonwalk_mini_wheel">
  <link name="base_link">
    <inertial>
      <origin xyz="-0.000752311 -0.000186166 0.0276769" rpy="0 0 0"/>
      <mass value="0.148875"/>
      <inertia ixx="6.85301e-05" ixy="2.08506e-08" ixz="1.04419e-06" iyy="0.00012395" iyz="1.38398e-07" izz="9.49926e-05"/>
    </inertial>
    <visual>
      <origin xyz="0 0 0" rpy="0 0 0"/>
      <geometry><mesh filename="meshes/base_link.stl" scale="0.001 0.001 0.001"/></geometry>
    </visual>
    <collision name="base_link_body">
      <origin xyz="0 0 0.01145" rpy="0 0 0"/>
      <geometry><box size="0.088 0.02 0.0309"/></geometry>
    </collision>
    <collision name="base_link_tray">
      <origin xyz="0 0 0.03595" rpy="0 0 0"/>
      <geometry><box size="0.086 0.042 0.0181"/></geometry>
    </collision>
    <collision name="base_link_battery">
      <origin xyz="0 0 0.053" rpy="0 0 0"/>
      <geometry><box size="0.032 0.058 0.016"/></geometry>
    </collision>
  </link>
  <link name="L_thigh">
    <inertial>
      <origin xyz="-3.1717e-05 0.000413886 -0.0573372" rpy="0 0 0"/>
      <mass value="0.0441085"/>
      <inertia ixx="2.805e-05" ixy="-5.79022e-10" ixz="-2.07556e-08" iyy="3.01334e-05" iyz="3.77418e-07" izz="5.68791e-06"/>
    </inertial>
    <visual>
      <origin xyz="0 0 0" rpy="0 0 0"/>
      <geometry><mesh filename="meshes/L_thigh.stl" scale="0.001 0.001 0.001"/></geometry>
    </visual>
    <collision name="L_thigh_body">
      <origin xyz="0 0 -0.0525" rpy="0 0 0"/>
      <geometry><box size="0.032 0.0228 0.072"/></geometry>
    </collision>
  </link>
  <link name="L_shank">
    <inertial>
      <origin xyz="-0.000366964 0.000478842 -0.0429678" rpy="0 0 0"/>
      <mass value="0.044157"/>
      <inertia ixx="1.69101e-05" ixy="3.71902e-07" ixz="-2.08975e-07" iyy="1.86269e-05" iyz="1.80009e-07" izz="5.02995e-06"/>
    </inertial>
    <visual>
      <origin xyz="0 0 0" rpy="0 0 0"/>
      <geometry><mesh filename="meshes/L_shank.stl" scale="0.001 0.001 0.001"/></geometry>
    </visual>
    <collision name="L_shank_body">
      <origin xyz="0 0 -0.04365" rpy="0 0 0"/>
      <geometry><box size="0.0246 0.022 0.0373"/></geometry>
    </collision>
  </link>
  <link name="L_foot">
    <inertial>
      <origin xyz="-0.00113277 0.00203122 -0.0145507" rpy="0 0 0"/>
      <mass value="0.0252884"/>
      <inertia ixx="9.51689e-06" ixy="-1.52885e-10" ixz="2.52436e-07" iyy="4.7501e-06" iyz="-5.5871e-07" izz="1.12301e-05"/>
    </inertial>
    <visual>
      <origin xyz="0 0 0" rpy="0 0 0"/>
      <geometry><mesh filename="meshes/L_foot_wheel.stl" scale="0.001 0.001 0.001"/></geometry>
    </visual>
    <collision name="L_foot_toe_pad">
      <origin xyz="0 0.0340365 -0.0162944" rpy="0.314159 0 0"/>
      <geometry><box size="0.044 0.0157719 0.003"/></geometry>
    </collision>
    <collision name="L_foot_heel">
      <origin xyz="0 -0.018 -0.025" rpy="0 0 0"/>
      <geometry><box size="0.0352 0.016 0.003"/></geometry>
    </collision>
    <collision name="L_foot_body">
      <origin xyz="0 0.001 -0.0085" rpy="0 0 0"/>
      <geometry><box size="0.042 0.05 0.009"/></geometry>
    </collision>
  </link>
  <link name="L_wheel">
    <inertial>
      <origin xyz="-2.73874e-19 8.27733e-21 -3.61246e-20" rpy="0 0 0"/>
      <mass value="0.00316341"/>
      <inertia ixx="1.73002e-08" ixy="2.60396e-25" ixz="-8.31953e-23" iyy="7.02231e-07" iyz="-1.14039e-24" izz="7.02231e-07"/>
    </inertial>
    <visual>
      <origin xyz="0 0 0" rpy="0 0 0"/>
      <geometry><mesh filename="meshes/L_wheel.stl" scale="0.001 0.001 0.001"/></geometry>
    </visual>
    <collision name="L_wheel_out">
      <origin xyz="-0.02 0 0" rpy="0 0 0"/>
      <geometry><sphere radius="0.006"/></geometry>
    </collision>
    <collision name="L_wheel_in">
      <origin xyz="0.02 0 0" rpy="0 0 0"/>
      <geometry><sphere radius="0.006"/></geometry>
    </collision>
  </link>
  <link name="R_thigh">
    <inertial>
      <origin xyz="3.1717e-05 0.000413886 -0.0573372" rpy="0 0 0"/>
      <mass value="0.0441085"/>
      <inertia ixx="2.805e-05" ixy="5.79022e-10" ixz="2.07556e-08" iyy="3.01334e-05" iyz="3.77418e-07" izz="5.68791e-06"/>
    </inertial>
    <visual>
      <origin xyz="0 0 0" rpy="0 0 0"/>
      <geometry><mesh filename="meshes/R_thigh.stl" scale="0.001 0.001 0.001"/></geometry>
    </visual>
    <collision name="R_thigh_body">
      <origin xyz="-0 0 -0.0525" rpy="0 0 0"/>
      <geometry><box size="0.032 0.0228 0.072"/></geometry>
    </collision>
  </link>
  <link name="R_shank">
    <inertial>
      <origin xyz="0.000366964 0.000478842 -0.0429678" rpy="0 0 0"/>
      <mass value="0.044157"/>
      <inertia ixx="1.69101e-05" ixy="-3.71902e-07" ixz="2.08975e-07" iyy="1.86269e-05" iyz="1.80009e-07" izz="5.02995e-06"/>
    </inertial>
    <visual>
      <origin xyz="0 0 0" rpy="0 0 0"/>
      <geometry><mesh filename="meshes/R_shank.stl" scale="0.001 0.001 0.001"/></geometry>
    </visual>
    <collision name="R_shank_body">
      <origin xyz="-0 0 -0.04365" rpy="0 0 0"/>
      <geometry><box size="0.0246 0.022 0.0373"/></geometry>
    </collision>
  </link>
  <link name="R_foot">
    <inertial>
      <origin xyz="0.00113277 0.00203122 -0.0145507" rpy="0 0 0"/>
      <mass value="0.0252884"/>
      <inertia ixx="9.51689e-06" ixy="1.52885e-10" ixz="-2.52436e-07" iyy="4.7501e-06" iyz="-5.5871e-07" izz="1.12301e-05"/>
    </inertial>
    <visual>
      <origin xyz="0 0 0" rpy="0 0 0"/>
      <geometry><mesh filename="meshes/R_foot_wheel.stl" scale="0.001 0.001 0.001"/></geometry>
    </visual>
    <collision name="R_foot_toe_pad">
      <origin xyz="-0 0.0340365 -0.0162944" rpy="0.314159 0 0"/>
      <geometry><box size="0.044 0.0157719 0.003"/></geometry>
    </collision>
    <collision name="R_foot_heel">
      <origin xyz="-0 -0.018 -0.025" rpy="0 0 0"/>
      <geometry><box size="0.0352 0.016 0.003"/></geometry>
    </collision>
    <collision name="R_foot_body">
      <origin xyz="-0 0.001 -0.0085" rpy="0 0 0"/>
      <geometry><box size="0.042 0.05 0.009"/></geometry>
    </collision>
  </link>
  <link name="R_wheel">
    <inertial>
      <origin xyz="-2.80766e-19 1.28706e-20 9.5161e-20" rpy="0 0 0"/>
      <mass value="0.00316341"/>
      <inertia ixx="1.73002e-08" ixy="-1.56256e-25" ixz="7.89776e-23" iyy="7.02231e-07" iyz="-1.10386e-24" izz="7.02231e-07"/>
    </inertial>
    <visual>
      <origin xyz="0 0 0" rpy="0 0 0"/>
      <geometry><mesh filename="meshes/R_wheel.stl" scale="0.001 0.001 0.001"/></geometry>
    </visual>
    <collision name="R_wheel_out">
      <origin xyz="0.02 0 0" rpy="0 0 0"/>
      <geometry><sphere radius="0.006"/></geometry>
    </collision>
    <collision name="R_wheel_in">
      <origin xyz="-0.02 0 0" rpy="0 0 0"/>
      <geometry><sphere radius="0.006"/></geometry>
    </collision>
  </link>
  <joint name="L_hip_pitch" type="revolute">
    <parent link="base_link"/>
    <child link="L_thigh"/>
    <origin xyz="-0.028 0 0" rpy="0 0 0"/>
    <axis xyz="1 0 0"/>
    <limit lower="-0.523599" upper="1.5708" effort="0.88" velocity="7.64"/>
  </joint>
  <joint name="L_knee_pitch" type="revolute">
    <parent link="L_thigh"/>
    <child link="L_shank"/>
    <origin xyz="0 0 -0.08" rpy="0 0 0"/>
    <axis xyz="-1 0 0"/>
    <limit lower="0" upper="2.0944" effort="0.88" velocity="7.64"/>
  </joint>
  <joint name="L_ankle_pitch" type="revolute">
    <parent link="L_shank"/>
    <child link="L_foot"/>
    <origin xyz="0 0 -0.072" rpy="0 0 0"/>
    <axis xyz="1 0 0"/>
    <limit lower="-0.610865" upper="0.523599" effort="0.88" velocity="7.64"/>
  </joint>
  <joint name="L_wheel_axle" type="continuous">
    <parent link="L_foot"/>
    <child link="L_wheel"/>
    <origin xyz="0 -0.018 -0.022" rpy="0 0 0"/>
    <axis xyz="1 0 0"/>
    <limit effort="0" velocity="200"/>
    <dynamics damping="2e-05" friction="0.0005"/>
  </joint>
  <joint name="R_hip_pitch" type="revolute">
    <parent link="base_link"/>
    <child link="R_thigh"/>
    <origin xyz="0.028 0 0" rpy="0 0 0"/>
    <axis xyz="1 -0 -0"/>
    <limit lower="-0.523599" upper="1.5708" effort="0.88" velocity="7.64"/>
  </joint>
  <joint name="R_knee_pitch" type="revolute">
    <parent link="R_thigh"/>
    <child link="R_shank"/>
    <origin xyz="0 0 -0.08" rpy="0 0 0"/>
    <axis xyz="-1 -0 -0"/>
    <limit lower="0" upper="2.0944" effort="0.88" velocity="7.64"/>
  </joint>
  <joint name="R_ankle_pitch" type="revolute">
    <parent link="R_shank"/>
    <child link="R_foot"/>
    <origin xyz="0 0 -0.072" rpy="0 0 0"/>
    <axis xyz="1 -0 -0"/>
    <limit lower="-0.610865" upper="0.523599" effort="0.88" velocity="7.64"/>
  </joint>
  <joint name="R_wheel_axle" type="continuous">
    <parent link="R_foot"/>
    <child link="R_wheel"/>
    <origin xyz="0 -0.018 -0.022" rpy="0 0 0"/>
    <axis xyz="1 -0 -0"/>
    <limit effort="0" velocity="200"/>
    <dynamics damping="2e-05" friction="0.0005"/>
  </joint>
</robot>
