Steven0811/moonwalk/(commit log)

2026-10-03 init commit
    [L_foot_ptfe.stl, L_foot_wheel.stl, L_shank.stl, L_thigh.stl, L_wheel.stl, R_foot_ptfe.stl, R_foot_wheel.stl, R_shank.stl]
2026-10-05 feat: add v1 gait
    [robot.yaml]
